Nikitarc/AASun-V2/DipTrace/AASun_V2.0.pdf

# Linky VCont

1

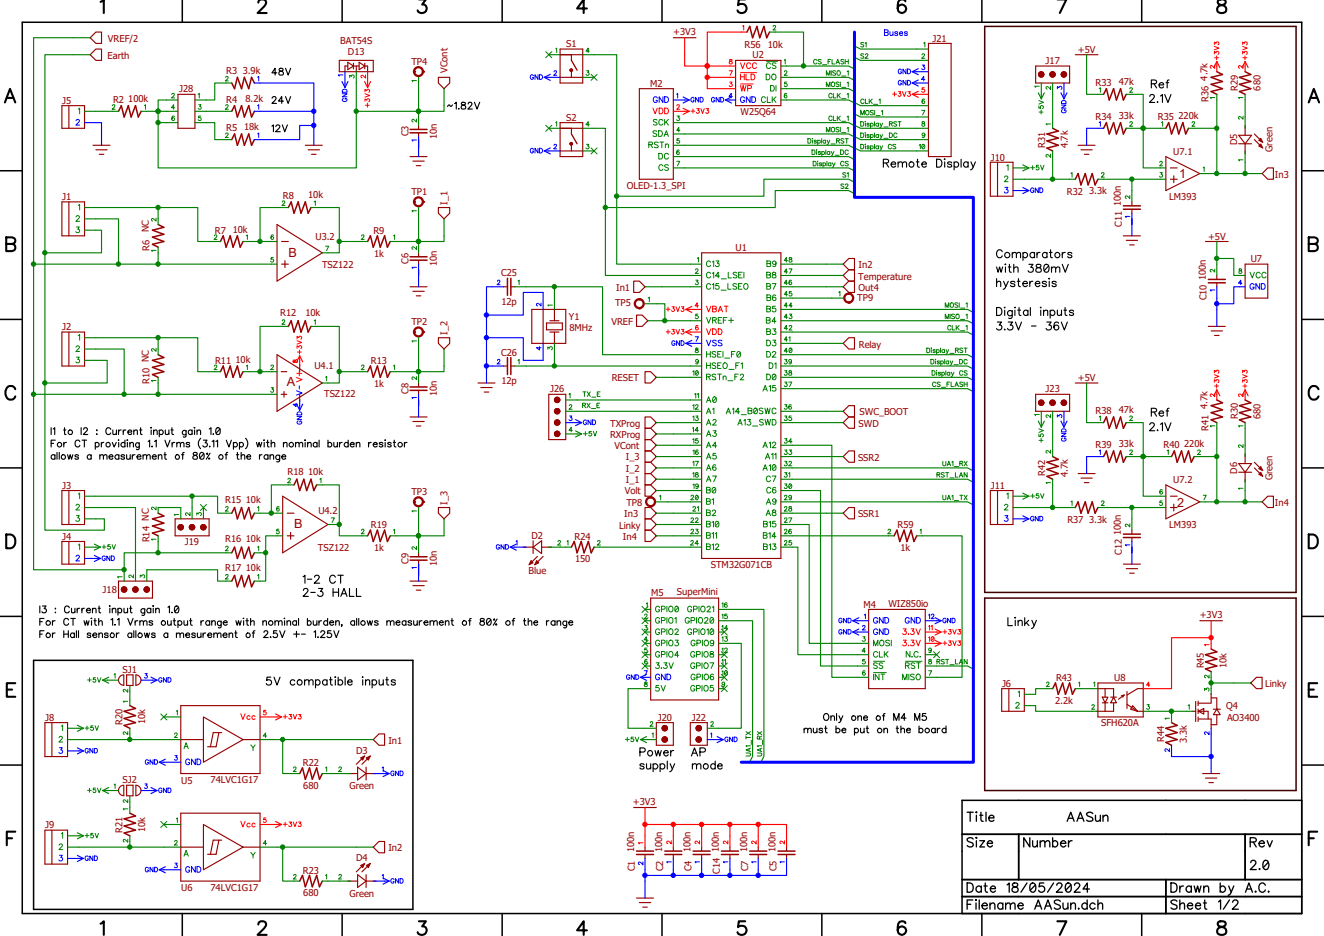
[picture p48: page 1]

Green | D¹¹ BAT54 | D¹² BAT54

A

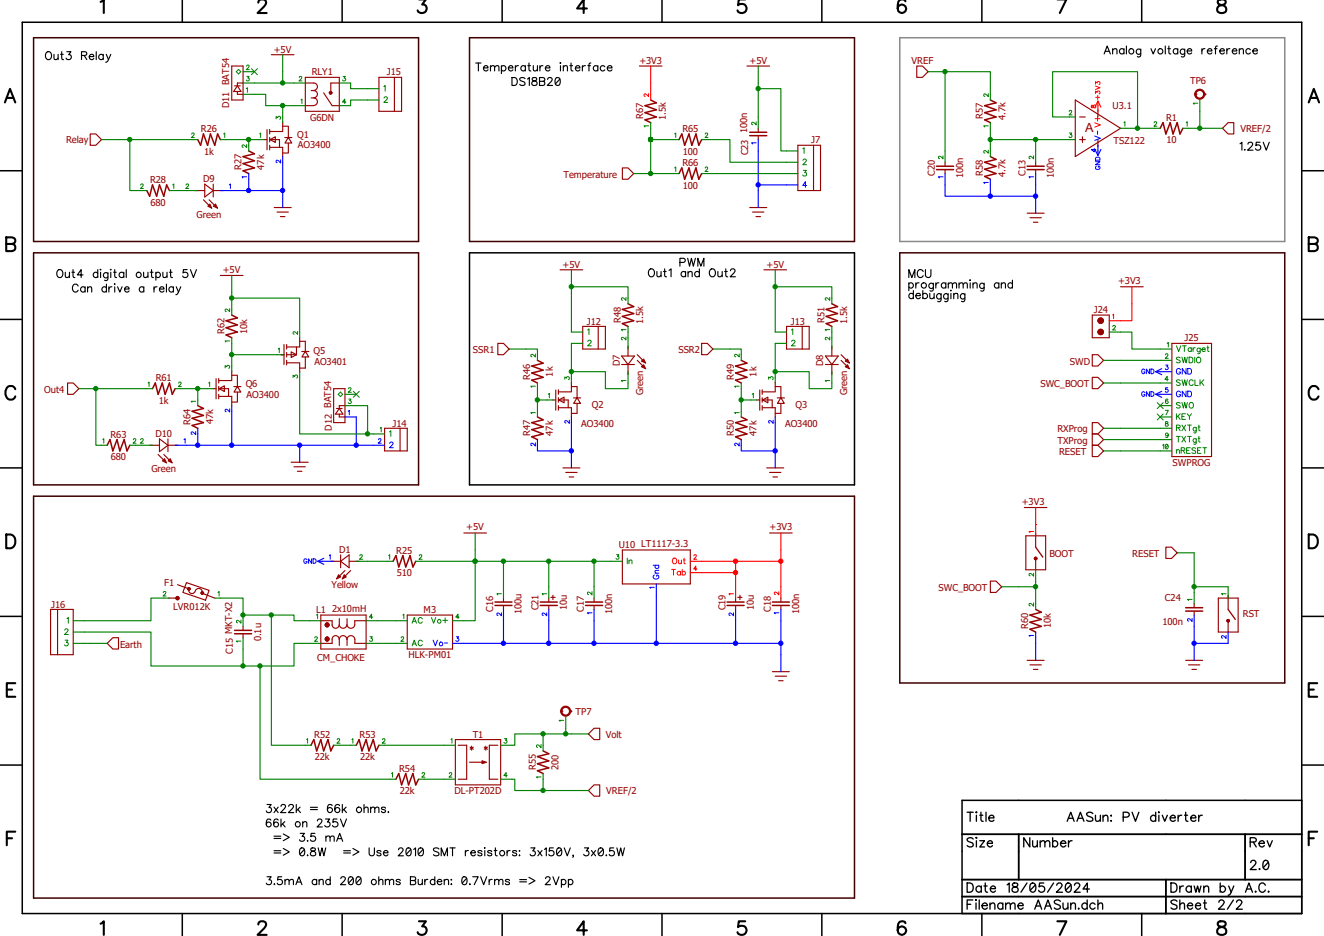
[picture p49: page 2]
