Nikitarc/AASun-V2/(list of files, drawings)

Other design files:
DipTrace/AASun.dch
DipTrace/AASun.dip
